SerraFacundo/CODAPLI-esp32-balancing-robot/iiot/README.md

# Plataforma IIoT local

Node-RED recibe la telemetría del robot por WebSocket y la guarda en InfluxDB; Grafana muestra
los KPIs (uptime, caídas, MTBF, batería). Todo corre en la laptop, sin depender de Internet.

## Requisitos

- Docker Desktop (Windows) o Docker Engine + compose.

## Levantar

```bash
cd iiot
cp .env.example .env      # en Windows: copy .env.example .env  — y editar las claves
docker compose up -d
```

| Servicio | URL |
|---|---|
| Node-RED | http://localhost:1880 |
| InfluxDB | http://localhost:8086 |
| Grafana  | http://localhost:3000 |

La laptop tiene que estar en la misma red que el robot (conectada al AP `BalanceBot`, o el
robot en modo AP+STA conectado a la red de la laptop).
