SerraFacundo/CODAPLI-esp32-balancing-robot/docs/hardware/3d_models/images/4c20db952ff5fd48003186e7504e393f.png

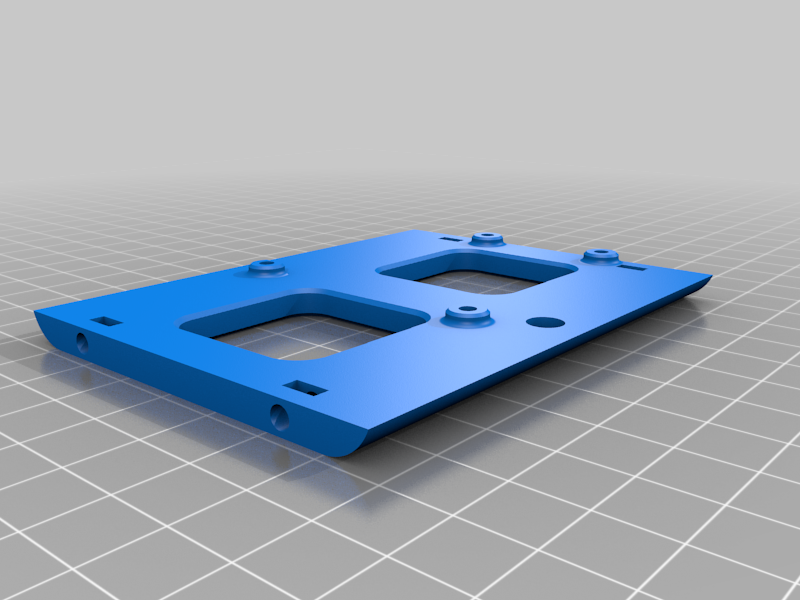
docs/hardware/3d_models/images/4c20db952ff5fd48003186e7504e393f.png
