SerraFacundo/CODAPLI-esp32-balancing-robot/docs/hardware/3d_models/images/5bf49b0fa93c81f15f6bee87551c77e2.png

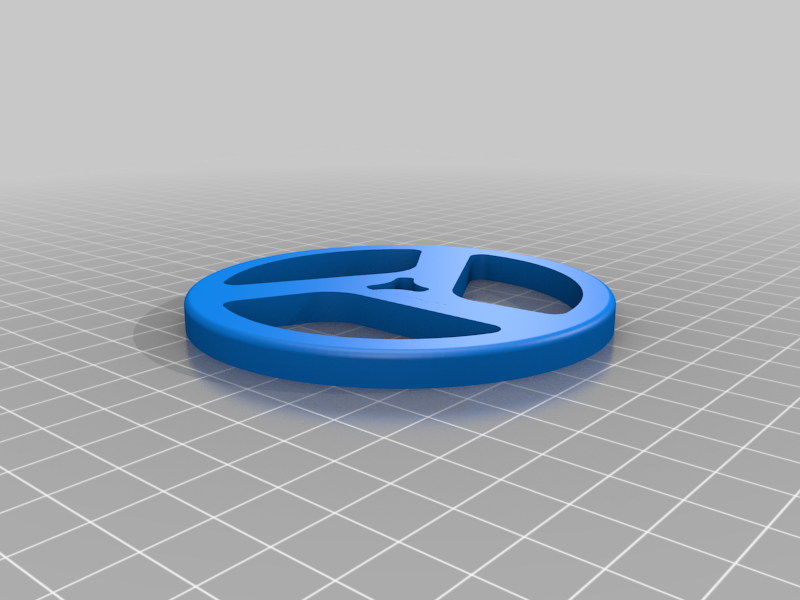
docs/hardware/3d_models/images/5bf49b0fa93c81f15f6bee87551c77e2.png
