SerraFacundo/CODAPLI-esp32-balancing-robot/docs/hardware/3d_models/images/8d9be31208e23f95b070aae8364dad93.png

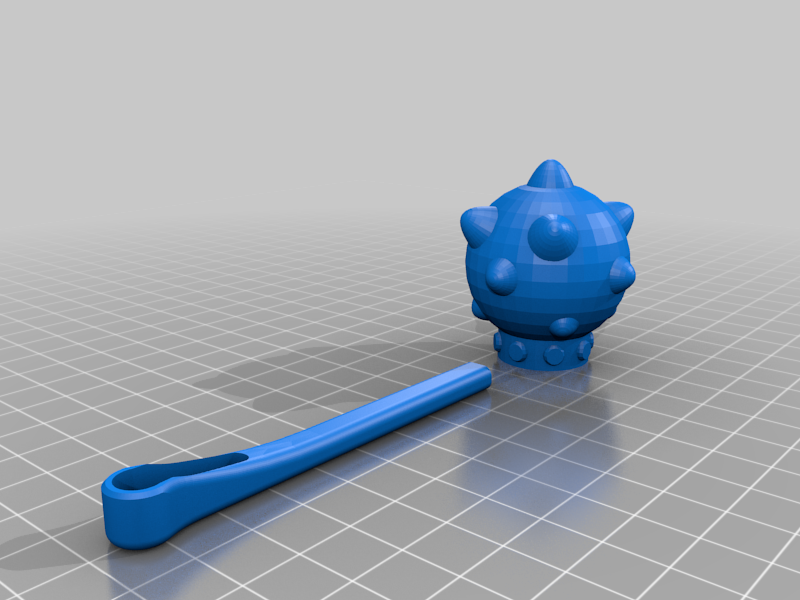
docs/hardware/3d_models/images/8d9be31208e23f95b070aae8364dad93.png
