SerraFacundo/CODAPLI-esp32-balancing-robot/docs/hardware/3d_models/images/16cff47c41e89eec614a1c143aa68d02.png

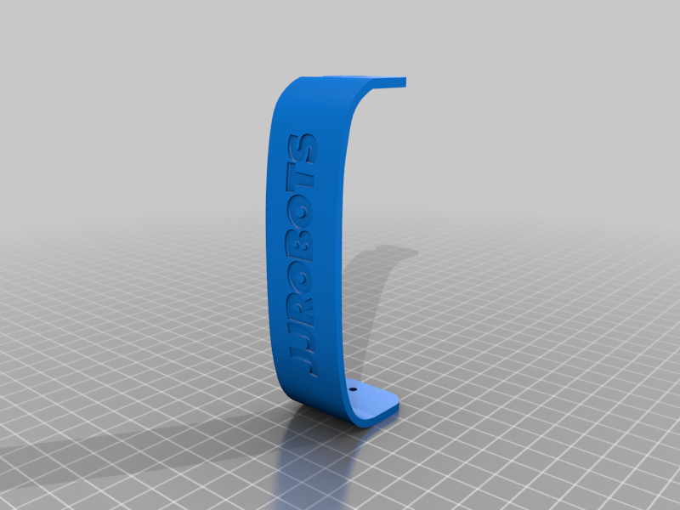
docs/hardware/3d_models/images/16cff47c41e89eec614a1c143aa68d02.png
