SerraFacundo/CODAPLI-esp32-balancing-robot/docs/hardware/3d_models/images/61bc6e7cdc0cfde9bbff6f61d479ba33.png

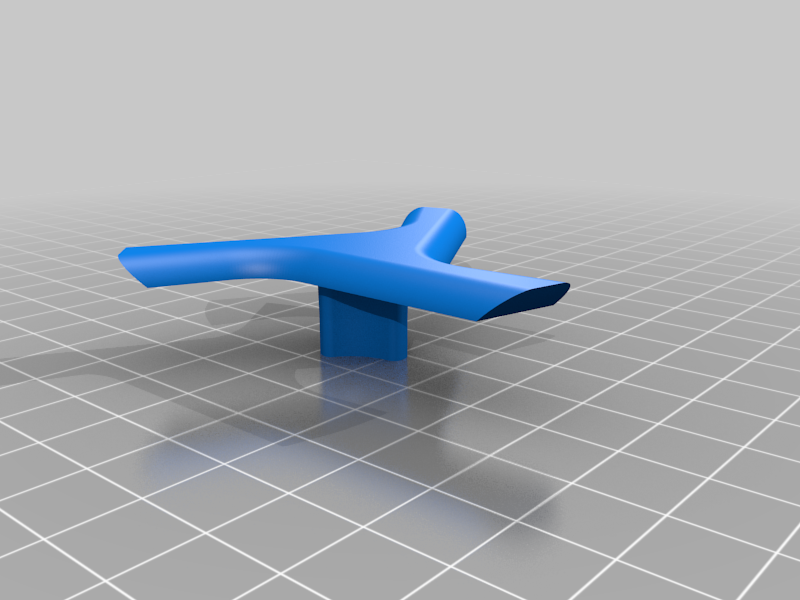
docs/hardware/3d_models/images/61bc6e7cdc0cfde9bbff6f61d479ba33.png
