SerraFacundo/CODAPLI-esp32-balancing-robot/docs/hardware/3d_models/images/68f0a22cc0f40ea2cccc04367e0b4912.png

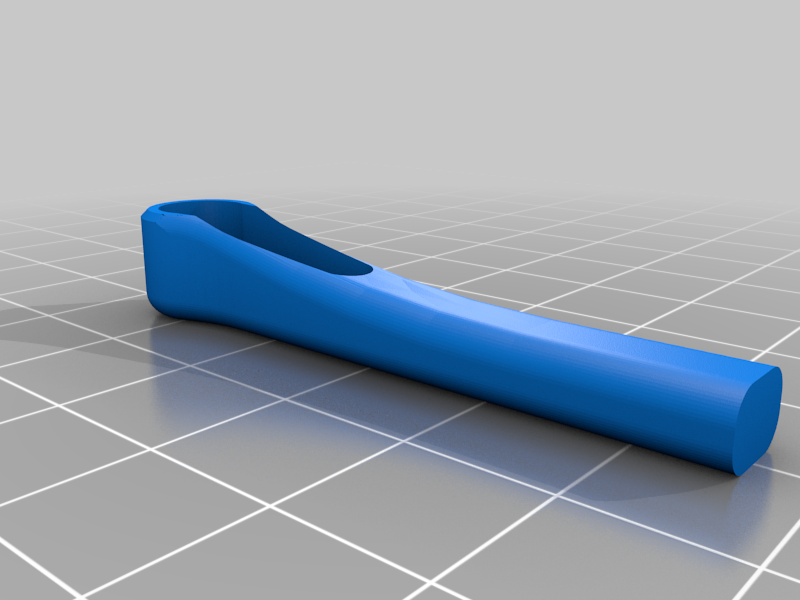
docs/hardware/3d_models/images/68f0a22cc0f40ea2cccc04367e0b4912.png
