SerraFacundo/CODAPLI-esp32-balancing-robot/docs/hardware/3d_models/images/80cbc48240ced8e4f472f1d73f79b2d7.png

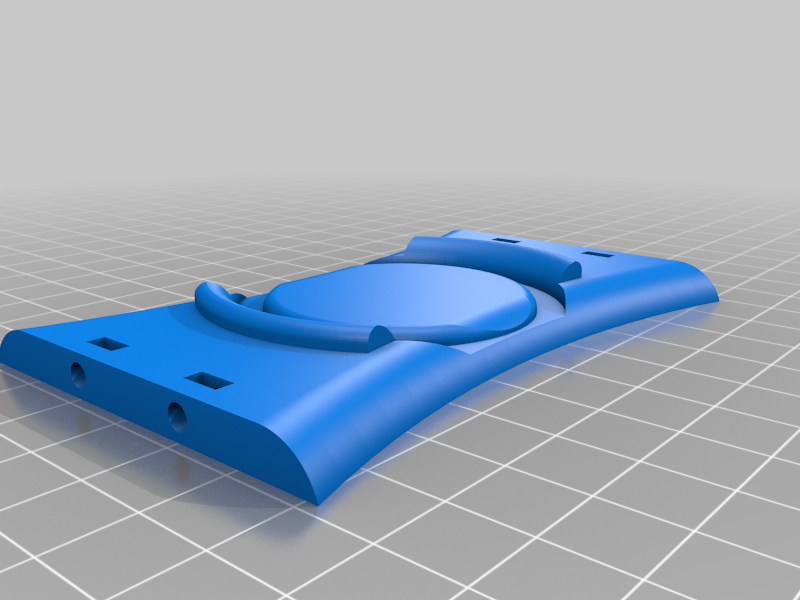
docs/hardware/3d_models/images/80cbc48240ced8e4f472f1d73f79b2d7.png
