SerraFacundo/CODAPLI-esp32-balancing-robot/docs/hardware/3d_models/images/772b4bf542d3530457f0eb0b5f1b1669.png

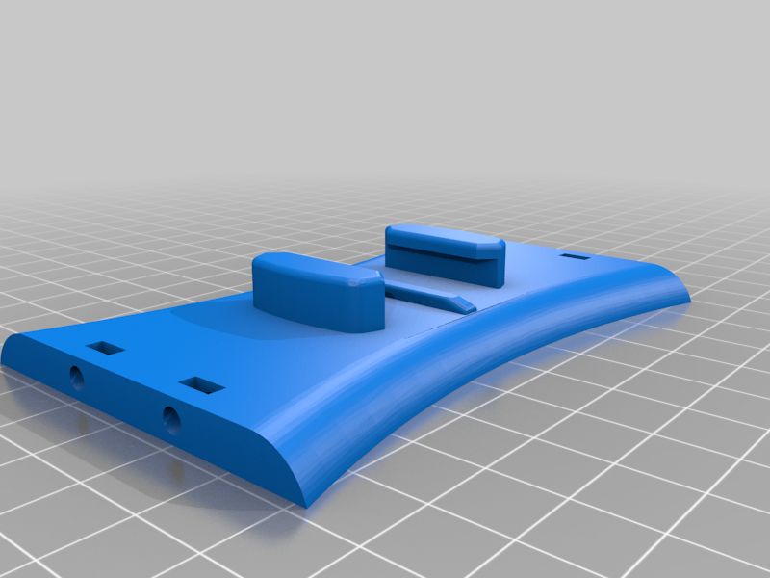
docs/hardware/3d_models/images/772b4bf542d3530457f0eb0b5f1b1669.png
