SerraFacundo/CODAPLI-esp32-balancing-robot/docs/hardware/3d_models/images/7163b6aa30b1eb0136e459a27a0f4336.png

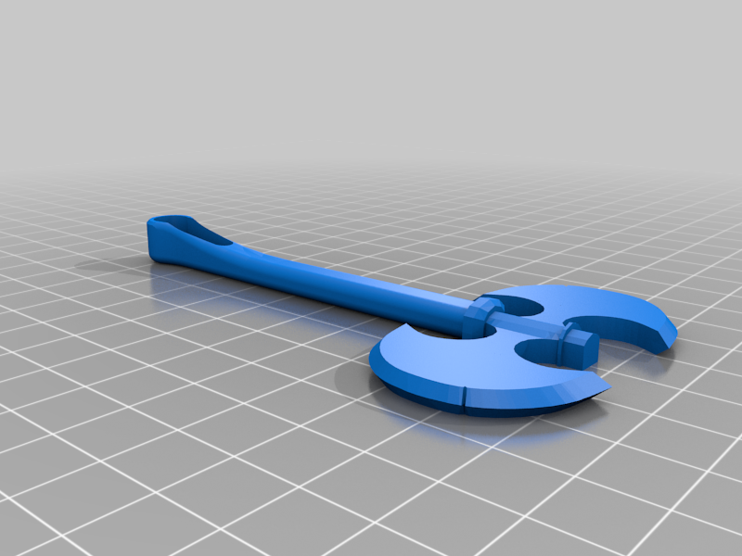
docs/hardware/3d_models/images/7163b6aa30b1eb0136e459a27a0f4336.png
