SerraFacundo/CODAPLI-esp32-balancing-robot/docs/hardware/3d_models/images/5833502223b9c937cd86ee0a13c6a1b8.png

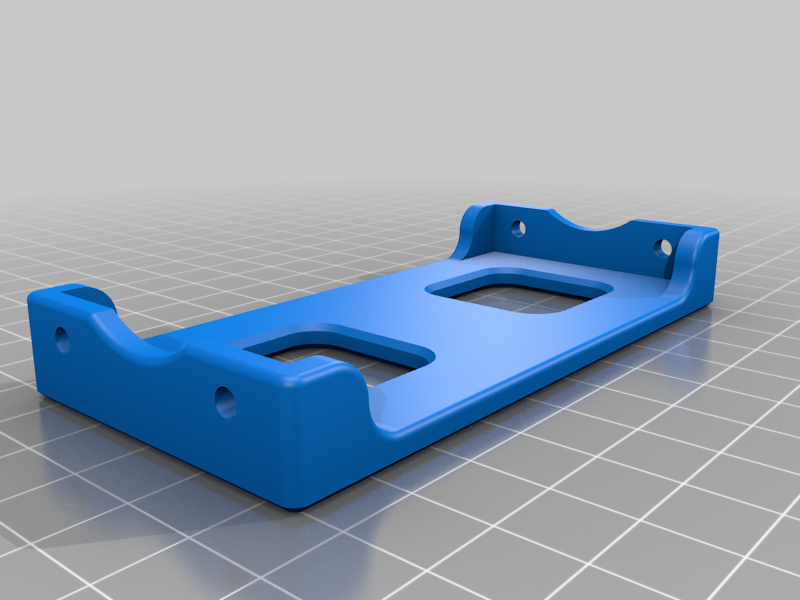
docs/hardware/3d_models/images/5833502223b9c937cd86ee0a13c6a1b8.png
