SerraFacundo/CODAPLI-esp32-balancing-robot/docs/hardware/3d_models/images/custom_bumper_v2.png

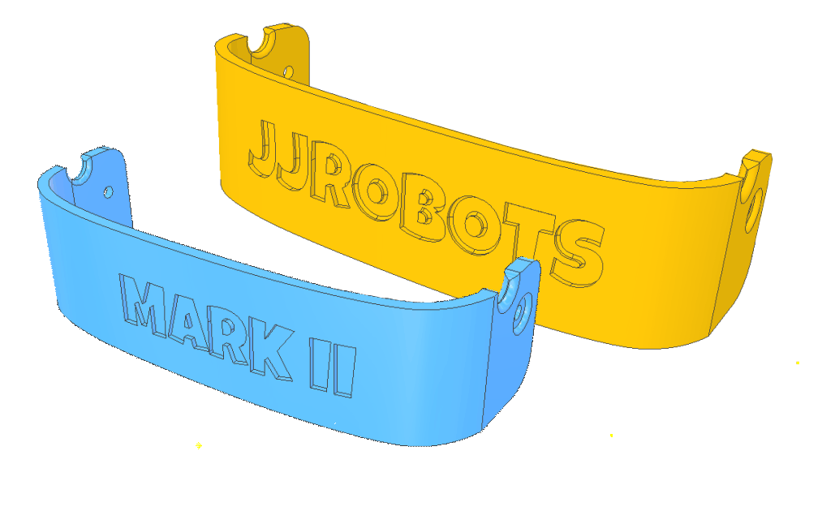
docs/hardware/3d_models/images/custom_bumper_v2.png
