SerraFacundo/CODAPLI-esp32-balancing-robot/docs/hardware/3d_models/images/d8cae396dcff10d9258286443fc57ae3.png

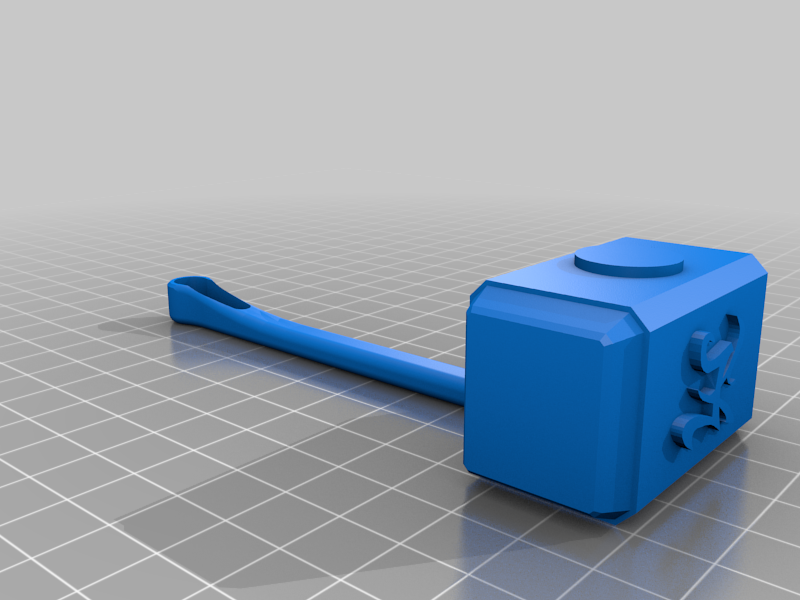
docs/hardware/3d_models/images/d8cae396dcff10d9258286443fc57ae3.png
