SerraFacundo/CODAPLI-esp32-balancing-robot/docs/hardware/3d_models/images/d641e6f85b85ff5e967c689aa312c9ad.png

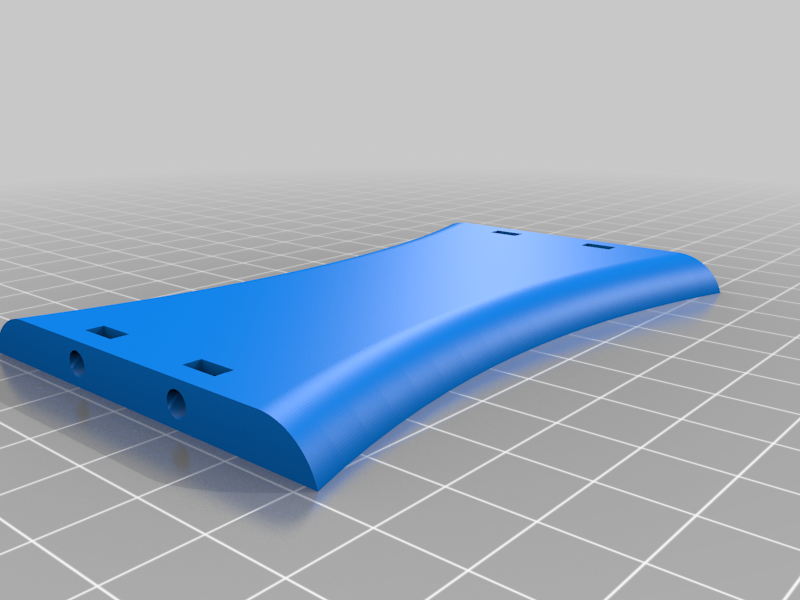
docs/hardware/3d_models/images/d641e6f85b85ff5e967c689aa312c9ad.png
