SerraFacundo/CODAPLI-esp32-balancing-robot/docs/hardware/3d_models/images/DSC_0267.jpg

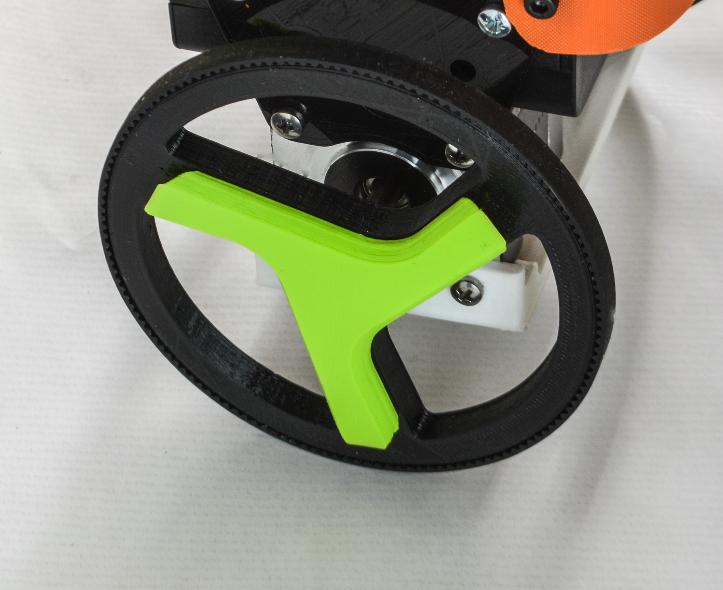
docs/hardware/3d_models/images/DSC_0267.jpg
