SerraFacundo/CODAPLI-esp32-balancing-robot/docs/hardware/3d_models/images/DSC_0294_v2.jpg

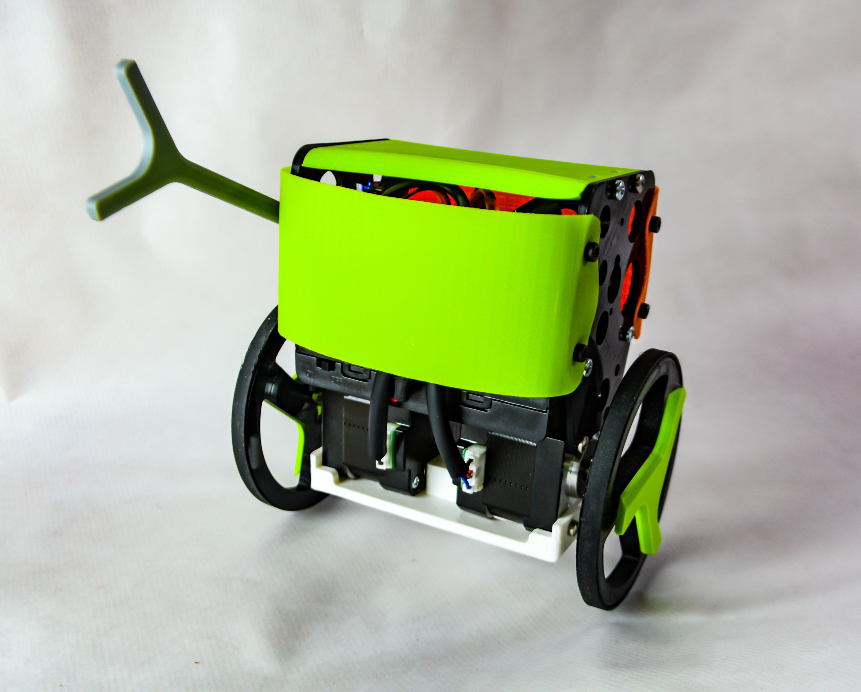
docs/hardware/3d_models/images/DSC_0294_v2.jpg
