SerraFacundo/CODAPLI-esp32-balancing-robot/docs/hardware/3d_models/images/Hand_Arm_Gualtierico_creation_[V2_short_.png

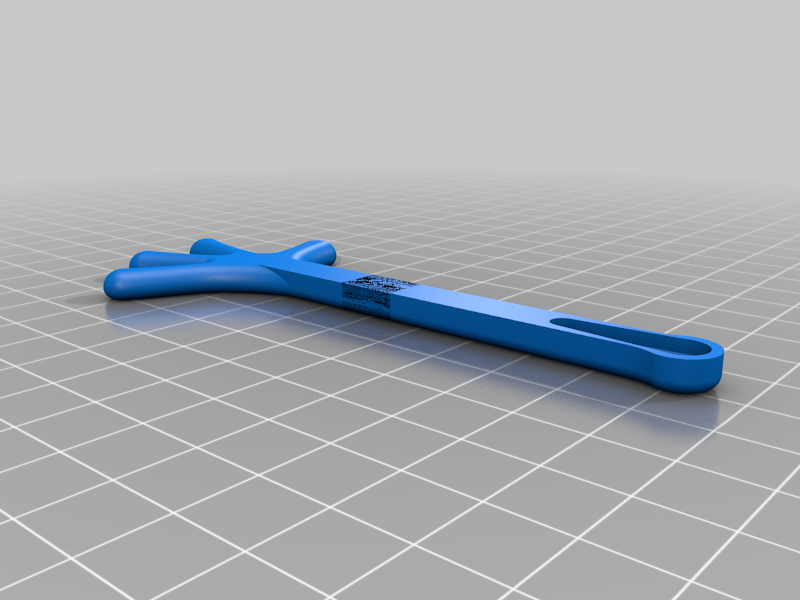
docs/hardware/3d_models/images/Hand_Arm_Gualtierico_creation_[V2_short_.png
