SerraFacundo/CODAPLI-esp32-balancing-robot/docs/hardware/3d_models/images/remote_control.jpg

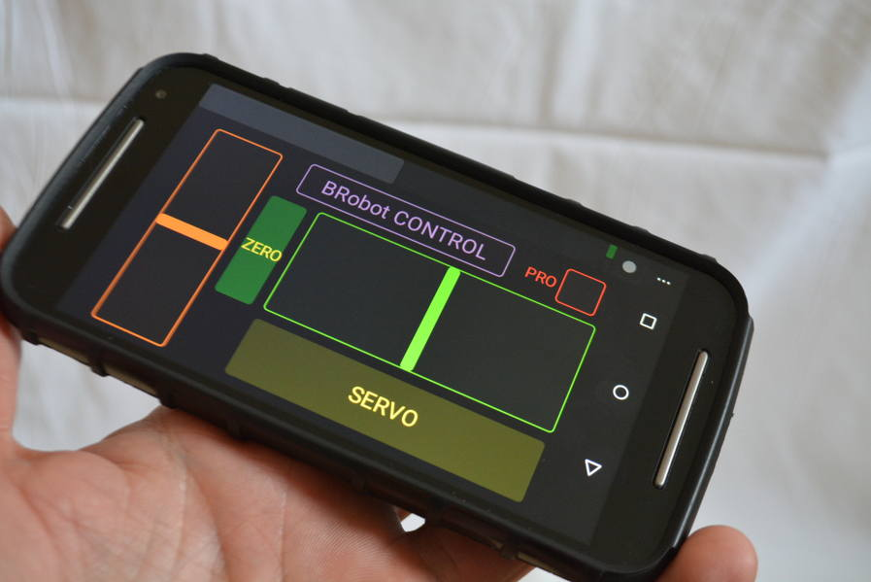
docs/hardware/3d_models/images/remote_control.jpg
