SerraFacundo/CODAPLI-esp32-balancing-robot/docs/hardware/3d_models/images/Side_Panel_[V11.png

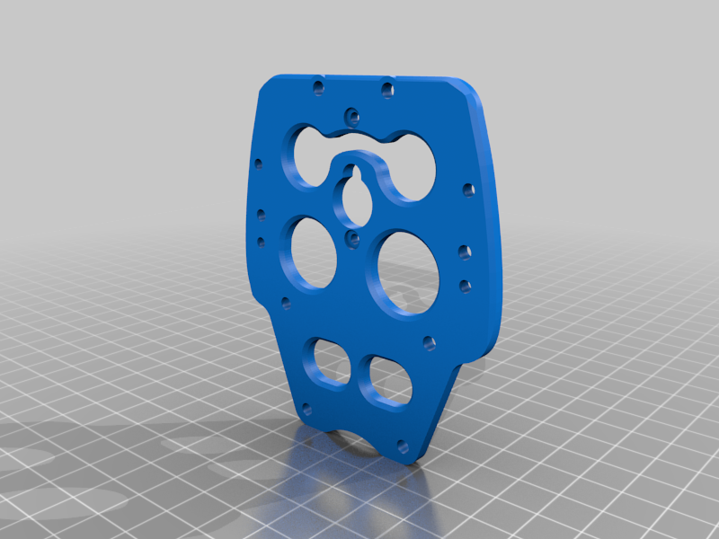
docs/hardware/3d_models/images/Side_Panel_[V11.png
