SerraFacundo/CODAPLI-esp32-balancing-robot/docs/hardware/3d_models/images/unnamed.jpg

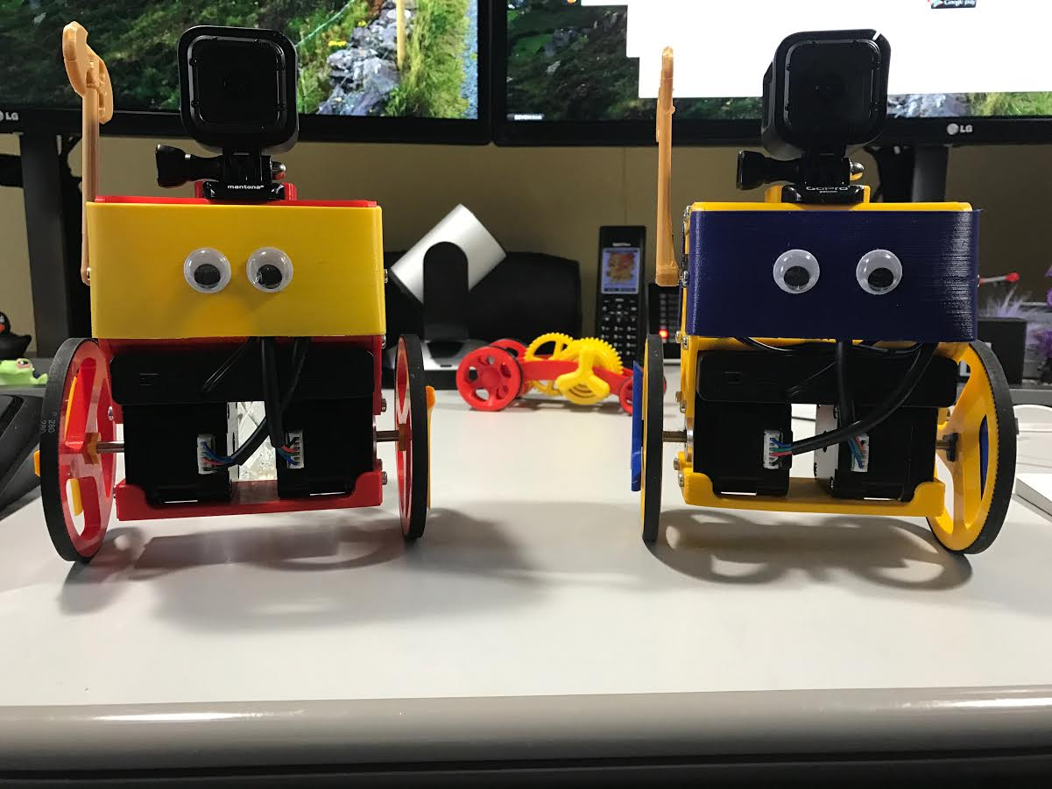
docs/hardware/3d_models/images/unnamed.jpg
