SerraFacundo/CODAPLI-esp32-balancing-robot/figs/comunication_diagram.png

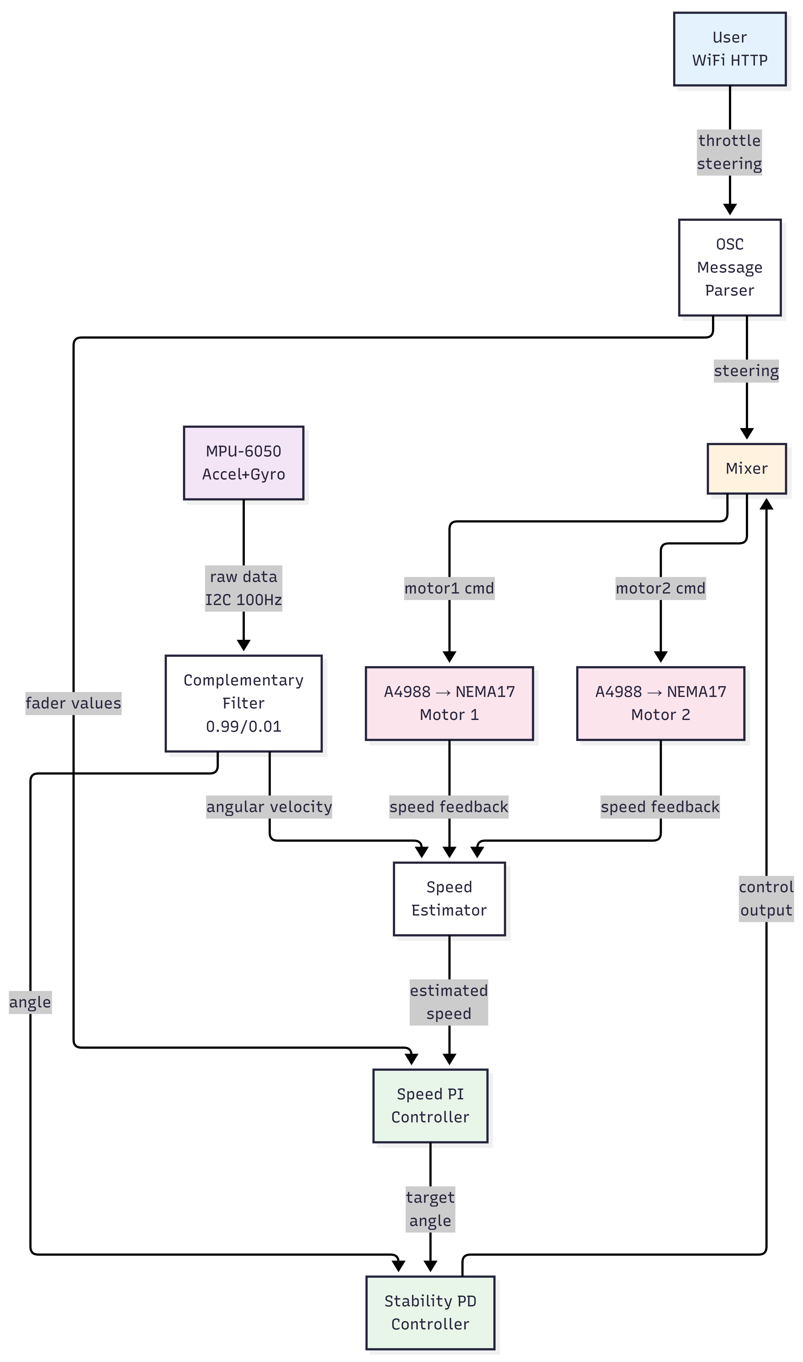
figs/comunication_diagram.png
