SerraFacundo/CODAPLI-esp32-balancing-robot/figs/hardware_diagram.png

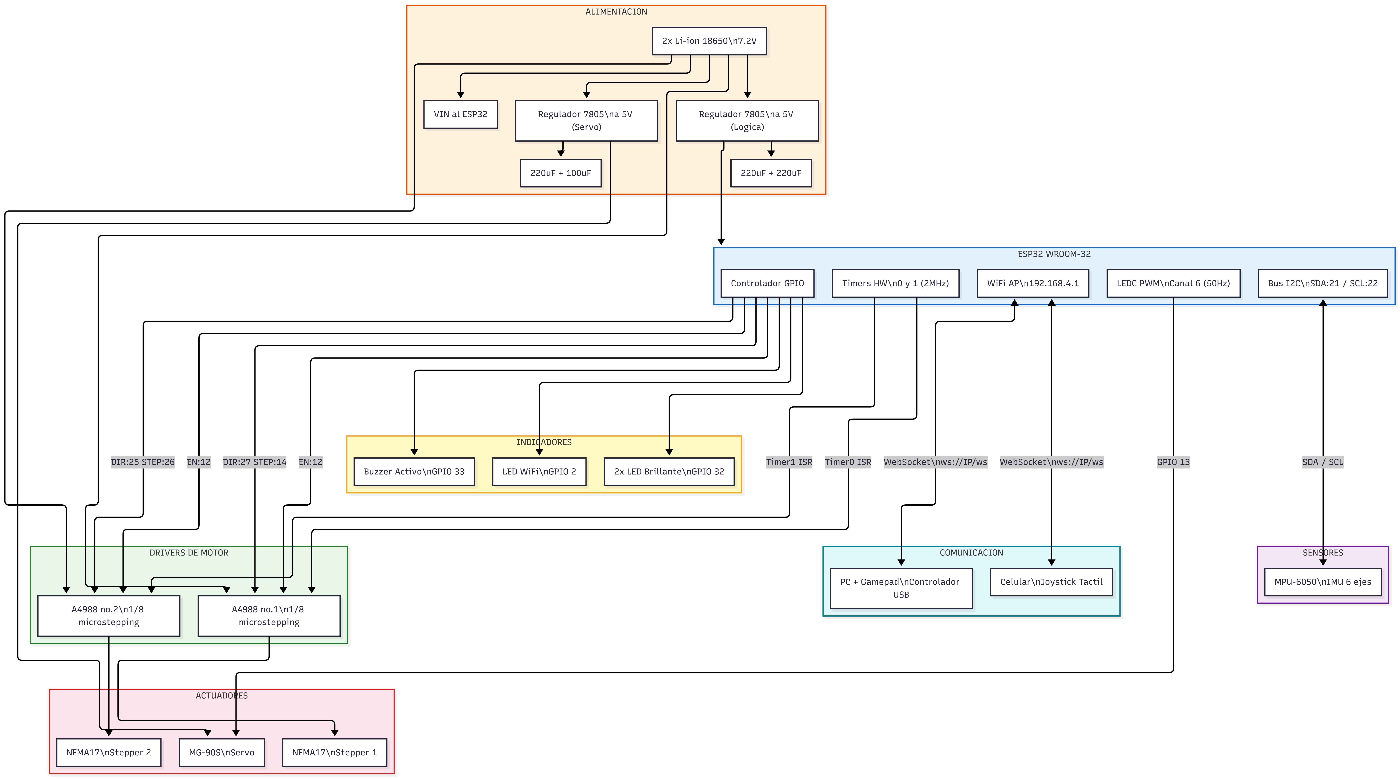
figs/hardware_diagram.png
