SerraFacundo/CODAPLI-esp32-balancing-robot/figs/pid_control_1.png

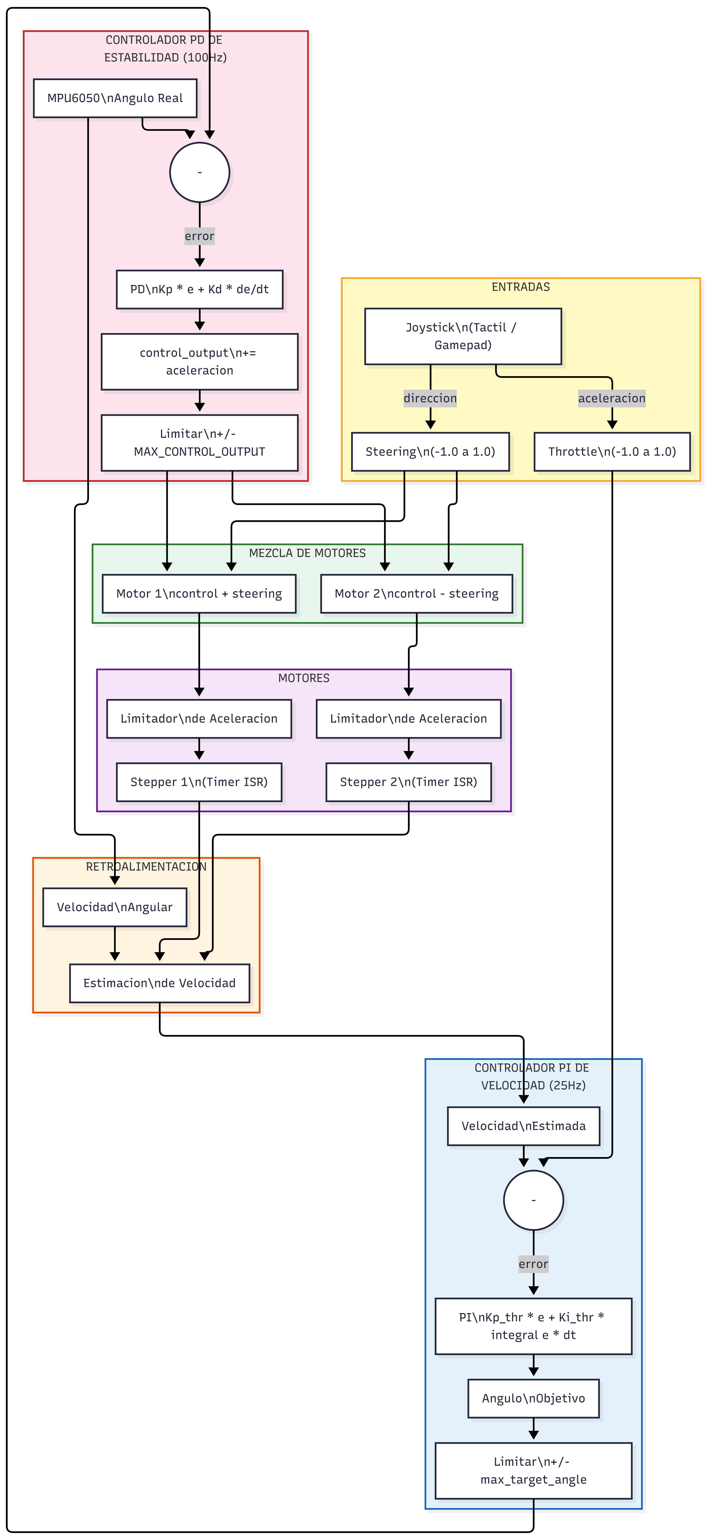
figs/pid_control_1.png
