SerraFacundo/CODAPLI-esp32-balancing-robot/figs/state_machine_1.png

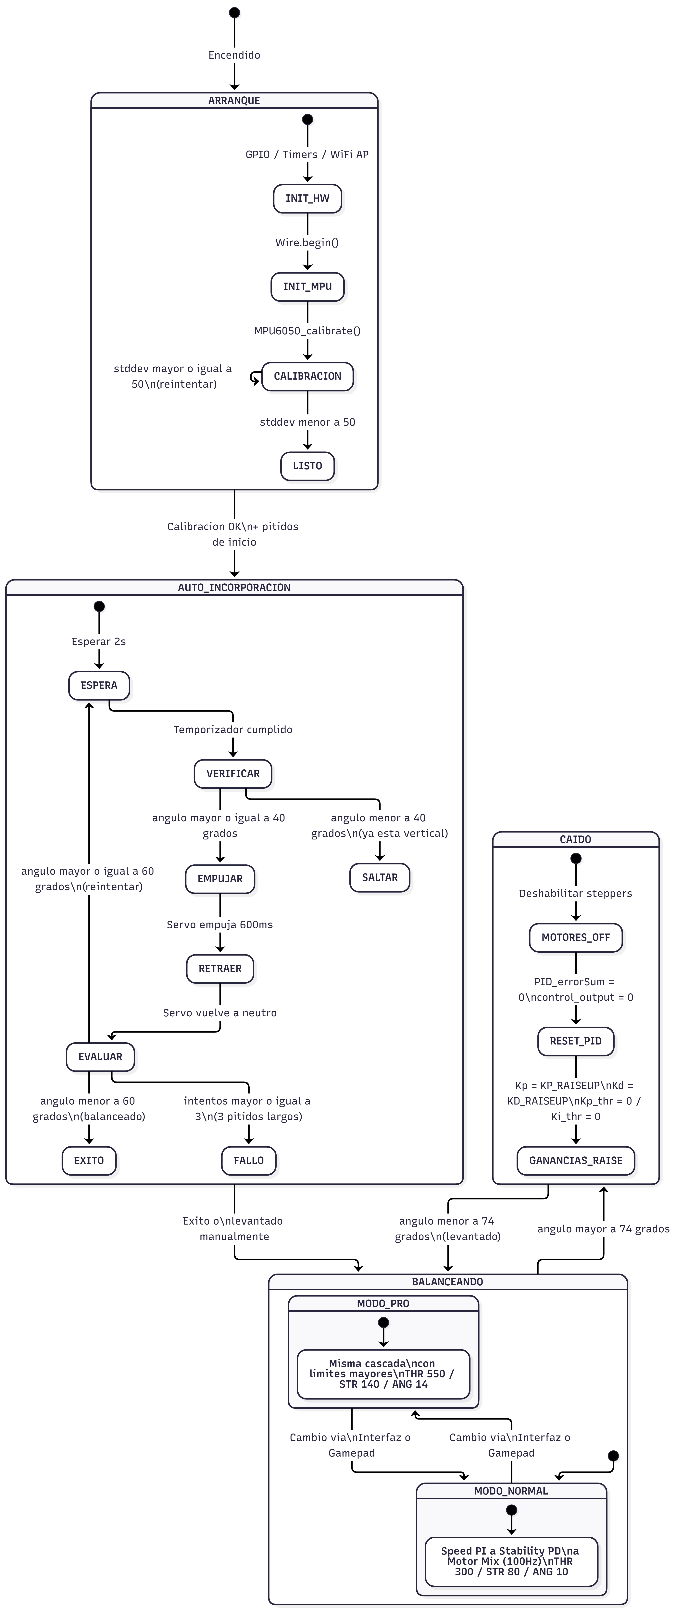
figs/state_machine_1.png
