SerraFacundo/CODAPLI-esp32-balancing-robot/hardware/image.png

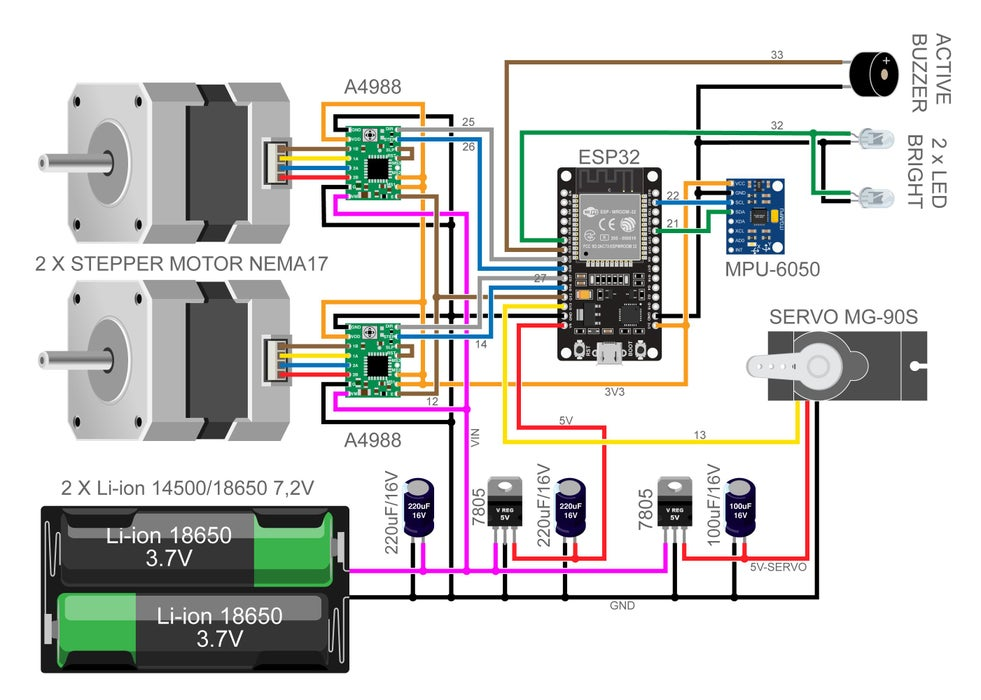
hardware/image.png
