SerraFacundo/CODAPLI-esp32-balancing-robot/docs/hardware/3d_models/files/Hand_Arm_Gualtierico_creation_[V2_short_.stl

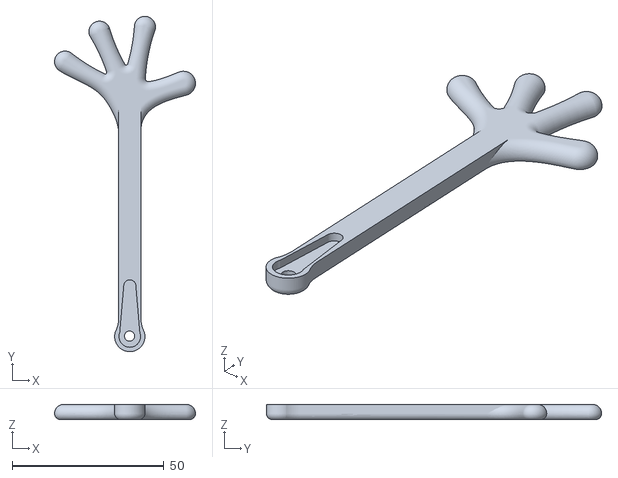
[picture p27: CAD file, 2026-02-28]
docs/hardware/3d_models/files/Hand_Arm_Gualtierico_creation_[V2_short_.stl
46.5 x 110.5 x 5.00
