SerraFacundo/CODAPLI-esp32-balancing-robot/firmware/src/Timers.h

/*
 * Timers.h
 * 
 * Hardware timer initialization for stepper motor pulse generation.
 * Note: The original codebase was missing this header file.
 */

#ifndef TIMERS_H_
#define TIMERS_H_

void initTimers();

#endif /* TIMERS_H_ */
