SerraFacundo/CODAPLI-esp32-balancing-robot/(commit log)

2026-02-28 add: todo el codigo base para el robot
2026-02-28 add: modelos 3D para los componentes del robot
2026-03-18 feat: Add comprehensive project documentation to README.md, including hardware, firmware architecture, and web interface details, complemented by new communication, state machine, PID, and hardware d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
